JamesBaak/ASLR/README.md

# ASLR
The American Sign Language Reader code for the whole system.
