JamesBaak/ASLR/Arduino/README.md

# ASLR - Arduino

This is an Arduino program for sequentially turning on IR emitters and recording the amount of current generated by them 
through IR receivers/photodiodes. The data collected is then sent to Serial for transmission to a Raspberry Pi 4.

This is a third year university project for undergraduate studies in computer engineering.
It was an experiment to test the feasiblity of creating an American sign language to text reader by referencing the University of 
Bristols's SensIR project.

https://www.youtube.com/watch?v=hCahI7ZRbOA

https://dl.acm.org/citation.cfm?id=3126594.3126604

## Set Up

What you'll need to run this program:
- x1 Arduino Uno
- x1 USB cable type A/B
- x2 CD74HC4067 (16:1) Multiplexers (Robojax)
- x4 Operational Amplifiers (LM324N - Texas Instruments)
- x14 IR Transmitters (SFH4556P - Osram Opto Semiconductors)
- x14 IR Receivers/Photodiodes (BPW34FA - Osram Opto Semiconductors)
- x14 100k Ohm Resistors
- x14 ...
- x14 22pF capacitors
- X14 2N2222A transitors (or 2N3904)

### IR Receiver Circuit

Using all 14 receivers and all 4 op amp chips will result in four identical subcircuits. Figure 1 below shows one of those four identical subcircuits. It is four transimpedance circuits (using one IR Receiver, one resistor, one capacitor each) all connected to an LM324N. The resistance values here are all 100k Ohms. The capacitance values here are all 22pF.

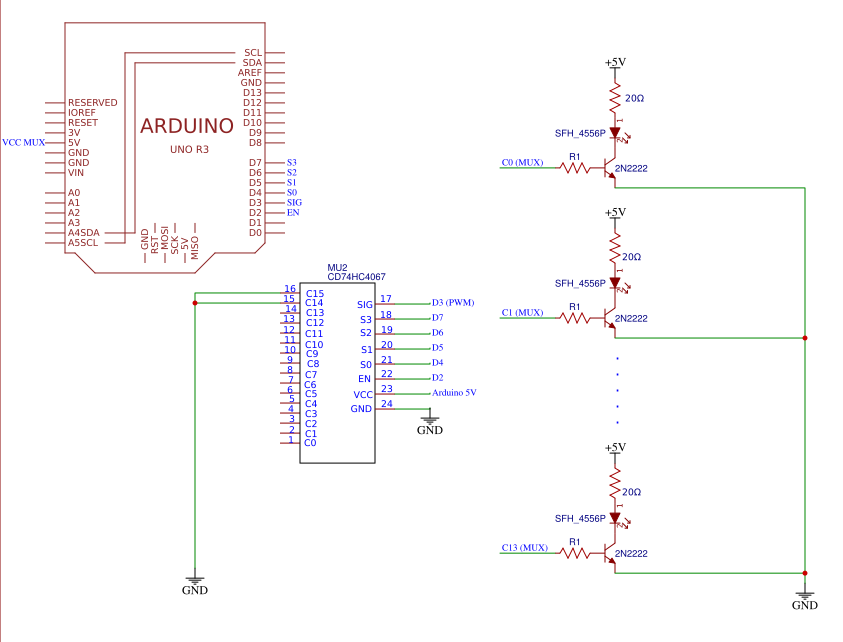
[picture p1: Arduino/circuit diagrams/irEmitters.png]
Image of Receiver Circuit 1/4

**Figure 1: 1 of 4 identical IR receiver subcircuits with 4 BPW34FAs and 1 LM324N**

Figure 2 below shows the full IR Receiver Circuit once all four subcircuits have been combined. 
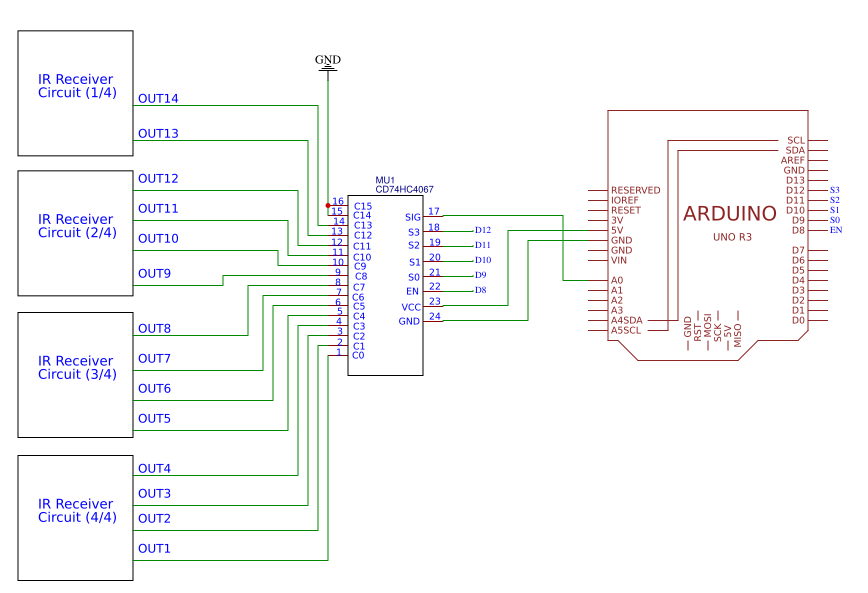
[picture p2: Arduino/circuit diagrams/irReceiversFULL.png]
Image of Full Receiver Circuit

**Figure 2: Full IR Receiver Circuit with 4 subcircuits, 1 mux and 1 Arduino Uno**

### IR Emitter Circuit

Each emitter is part of its own transistor circuit involving a 2N2222A transitor, a X resistor connected to the transistor base and a X resitor in series with the LED at the transitor collector. This is to amplify the signal that is put out by the IR LEDs. Each transistor circuit is connected to one channel of the MUX. There are 14 of these transistor circuits.

Image of Full Receiver Circuit
**Figure 3: The IR Emitter circuit**

### Steps
1. Set up the circuits shown above
2. Open the program.io sketch in the Arduino IDE
3. Set up Serial.print() lines or use the sendVoltage method to send out on the TX pin
4. Verify the sketch
5. Connect the Arduino UNO
6. Upload the sketch to the Arduino Uno
