JamesBaak/ASLR/Arduino/circuit diagrams/irReceivers.png

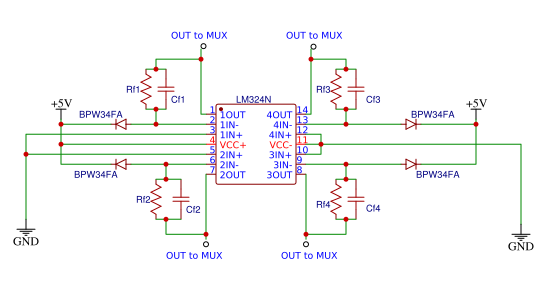
Arduino/circuit diagrams/irReceivers.png
