JamesBaak/ASLR/(threads)

Thread 2 (2019-11-17):

Fix App GUI

maaikegooderham, 2019-11-17:
Fix Android app GUI. Constraint layout is not working for a larger screen and it's messing up the placement of the buttons and text.

maaikegooderham, 2019-12-01:
Fixed!

Closed 2019-12-01.
