JamesBaak/ASLR/MLBox/main.py

import serial_buffer
import socket
import json

# Note: Machine learning algorithm from SensIR specs in their paper at: https://dl.acm.org/citation.cfm?doid=3126594.3126604
import numpy as np
from sklearn.multiclass import OneVsRestClassifier
from sklearn.neural_network import MLPClassifier
from sklearn.preprocessing import StandardScaler
from sklearn import model_selection
from sklearn.preprocessing import MultiLabelBinarizer

PORT = 1024
HOST_ADDRESS = ""
ACK   = { "type": "ack", "payload": "" }
ERROR = { "type": "error", "payload": "" }
SAVE  = { "type": "save", "payload": {} }

#Setup the ML model
clf = OneVsRestClassifier(MLPClassifier(solver='lbfgs', alpha=0.05, hidden_layer_sizes=(24,), random_state=1))
scaler = StandardScaler()
mlb = MultiLabelBinarizer()
# Must have at least one sample in order to fit and make predictions using the classifier.
# Without it new users will be unable to use the system.
s_labels = [1]
s_features = [
    [0.12, 0.14, 0.13, 0.14, 0.14, 0.14, 0.14, 0.12, 0.14,
     0.12, 0.13, 0.12, 0.77, 0.16, 0.12, 0.12, 0.12, 0.12,
     0.11, 0.12, 0.12, 0.12, 0.13, 0.12, 0.12, 0.12, 0.12,
     0.12, 0.12, 0.12, 0.12, 0.12, 0.13, 0.12, 0.12, 0.12,
     0.12, 0.12, 0.13, 0.12, 0.13, 0.12, 0.12, 0.12, 0.12,
     0.12, 0.12, 0.12, 0.12, 0.12, 0.14, 0.12, 0.12, 0.12,
     0.13, 0.12, 0.12, 0.12, 0.14, 0.12, 0.12, 0.12, 0.12,
     0.12, 0.13, 0.12, 0.13, 0.12, 0.12, 0.12, 0.13, 0.12,
     0.13, 0.12, 0.13, 0.12, 0.12, 0.12, 0.12, 0.12, 0.12,
     0.12, 0.12, 0.12, 0.14, 0.12, 0.14, 0.12, 0.12, 0.12,
     0.12, 0.12, 0.13, 0.12, 0.12, 0.12, 0.13, 0.12, 0.12,
     0.11, 0.13, 0.12, 0.14, 0.12, 0.13, 0.12, 0.12, 0.12,
     0.14, 0.12, 0.12, 0.12, 0.12, 0.12, 0.13, 0.12, 0.13,
     0.12, 0.13, 0.12, 0.12, 0.12, 0.14, 0.12, 0.13, 0.12,
     0.12, 0.12, 0.13, 0.12, 0.14, 0.12, 0.14, 0.12, 0.14,
     0.12, 0.14, 0.12, 0.14, 0.12, 0.14, 0.12, 0.78, 0.16,
     0.12, 0.14, 0.12, 0.12, 0.14, 0.12, 0.12, 0.12, 0.13,
     0.12, 0.12, 0.12, 0.13, 0.12, 0.14, 0.13, 0.85, 0.18,
     0.12, 0.13, 0.14, 0.12, 0.12, 0.14, 0.14, 0.12, 0.11,
     0.13, 0.14, 0.12, 0.12, 0.12, 0.12, 0.12, 0.12, 0.79,
     0.16, 0.78, 0.16, 0.13, 0.12, 0.14, 0.12, 0.14, 0.12,
     0.12, 0.12, 0.13, 0.12, 0.12, 0.13, 0.13]
]
labels   = s_labels
features = s_features
loaded = False

def __constructJSON__(msgType, msg):
        """
        Construct an error json for UDP response
        msg [string] - The payload of the error message
        """
        m_json = msgType.copy()
        m_json["payload"] = msg
        return m_json

def handleSample(socket, address, payload, buffer):
    """
    If payload is 0 then the ML algorithm does not need to retrain.
    Greater than 0 indicts a gesture and the known class will be added 
    to the training data set to train model again before prediction.
    Finally, return the response back to server.
    socket - socket of request
    address - response address
    payload [int] - A zero for no class and greater than 0 representing a gesture
    """
    print("Training model and prediction commencing...")

    # The buffer isn't ready
    if (buffer[0]) == None:
        socket.sendto(
            bytes(json.dumps(__constructJSON__(ERROR, "Buffer not ready yet...")), "utf-8"),
            address
        )
    else:
        in_vector = np.array(buffer)

        if payload == 0:
            print("No gesture selected, skipping training...")
        else:
            labels.append(payload)
            features.append(in_vector)
            train_model()
            
        #Prediction
        # Get last prediction. Sadly no prediction of single input
        pred = clf.predict(np.array(features))[-1]
        result = {
            "prediction": int(pred),
            "class": int(payload),
            "input": in_vector.tolist()
        }

        socket.sendto(
            bytes(json.dumps(__constructJSON__(SAVE, result)), "utf-8"),
            address
        )

def train_model():
    acccuracy = -0.0
    # Do this so we can avoid overfitting due to our small data set
    if len(features) >= 10:
        X_train, X_test, y_train, y_test = model_selection.train_test_split(np.array(features), np.array(labels), test_size=0.3, random_state=42)
        clf.fit(X_train,y_train)
        acccuracy = clf.score(X_test, y_test)
    else:
        X_train, y_train = np.array(features), np.array(labels)
        clf.fit(X_train,y_train)

    print("Model Trained...")
    print("Accuracy: {}".format(acccuracy))

def handleLoad(socket, address, payload):
    global loaded
    global labels
    global features
    
    if loaded:
        features = s_features
        labels = s_labels
        loaded = False

    for rec in payload["records"]:
        if (rec["class"] and rec["input"]):
            labels.append(rec["class"])
            features.append(rec["input"])
    
    if payload["remaining"] == 0:
        loaded = True
    print("Loading records complete... Training model")
    train_model()



def main():
    # Host setup
    sock = socket.socket(socket.AF_INET, socket.SOCK_DGRAM)
    host_address = (HOST_ADDRESS, PORT)
    sock.bind(host_address)
    # Buffer setup
    sb = serial_buffer.SerialBuffer('/dev/ttyACM0',9600)
    sb.debug = True
    sb.start()

    # Loop to wait for sample requests to then return the sample data to save.
    while True:
        print("Waiting for sample request...")
        buf, address = sock.recvfrom(PORT)

        if not len(buf):
            break

        request = json.loads(buf.decode("utf-8"))

        print(request)

         # Check to see if type and payload are in the json message request to the server
        if not "type" in request:
            sock.sendto(
                bytes(json.dumps(__constructJSON__(ERROR, "Missing type field...")), "utf-8"),
                address
            )
        elif not "payload" in request:
            sock.sendto(
                bytes(json.dumps(__constructJSON__(ERROR, "Missing payload field...")), "utf-8"),
                address
            )
        # Valid request structure, so handle it if valid type, else reply with error message
        else:
             # Process request
            if request["type"] == "sample": # Send request to ML PI to sample and return response
                handleSample(sock, address, request["payload"], sb.readBuffer())
            elif request["type"] == "load":
                handleLoad(sock, address, request["payload"])
            else: # Request type not specified
                sock.sendto(
                    bytes(json.dumps(__constructJSON__(ERROR, "Unknown type field...")), "utf-8"),
                    address
                )

if __name__ == "__main__":
    main()
