JamesBaak/ASLR/MLBox/Tests/udp_client.py

# A simple upd client for testing the server during setup

import socket
import sys
import json

HOST, PORT = "localhost", 9999
data = {
    "type": "get_user",
    "payload" : "james"
}
data = {
    "type": "create_user",
    "payload": {
        "username": "testUser",
        "saltValue": "0xFFFF",
        "password": "test123",
        "developer": 0 
    }
}

# data = {
#     "type": "sample",
#     "payload": ""
# }

# SOCK_DGRAM is the socket type to use for UDP sockets
sock = socket.socket(socket.AF_INET, socket.SOCK_DGRAM)

# As you can see, there is no connect() call; UDP has no connections.
# Instead, data is directly sent to the recipient via sendto().
sock.sendto(bytes(json.dumps(data), "utf-8"), (HOST, PORT))
received = str(sock.recv(1024), "utf-8")

print("Sent:     {}".format(data))
print("Received: {}".format(received))

# received = str(sock.recv(1024), "utf-8")

# print("Sent:     {}".format(data))
# print("Received: {}".format(received))
