JamesBaak/ASLR/(commit log)

2019-11-08 [Author: Alyssa Mathias] type: feat code for the arduino. sequentially select ir emitters to turn on and sequentially select ir receivers to collect data from
2019-11-13 James Baak [feat] - Start of the server and database access
    [udp_client.py]
2019-11-14 [AUTHOR: Alyssa Mathias] [type: bug] inserted the arduino program into a folder so it could be run and compiled
    [program.ino]
2019-11-14 AUTHOR: Alyssa Mathias [type: style] organized arduino code in a more readeable fashion
2019-11-14 James [feat] - The server interface to Android app is now functioning
    [udp_client.py]
2019-11-17 James [feat] - Added the MLBox<->arduino buffer
    [main.py, serial_buffer.py, serial_test.py, udp_client.py]
2019-11-17 [author: alyssa] [type: feat] added test functions for hardware, changed some variable names and fixed comments
    [program.ino]
2019-11-18 James [feat] - Send the IR voltage readings over to the Serial connection
    [program.ino]
2019-11-18 James [feat] - The start of the ML algorithm. Need some data for testing.
    [main.py]
2019-11-18 [author: alyssa] [type: change] added some comments and improved test code for arduino
2019-11-18 James [feat] - Updated server to handle load and sample of records with the ML Pi
    [serial_buffer.py]
2019-11-20 James [feat] - Finished start of the machine learning pi main code and also the communication between the server and the ML pi. Need testing data to start training the Pi and saving entries to databa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
    [main.py]
2019-11-26 Author: Alyssa Type: Refactor Cleaned up and improved Arduino code
2019-11-29 James [chore] - Commit changes to the database automatically and server standalone without ML Pi running
    [udp_client.py]
2019-12-01 Updated Arduino README
2019-12-01 added circuit diagrams for arduino
2019-12-01 Completed readme for arduino code
2019-12-03 cleaned up arduino code. ready for review
2019-12-04 arduino sketch for demo
2019-12-04 [Maaike Gooderham] fix: Updated IP addresses and fixed sample activity
